WeSpeakEnglish/SEN6x_to_KEL_adapter/conn_tme.png

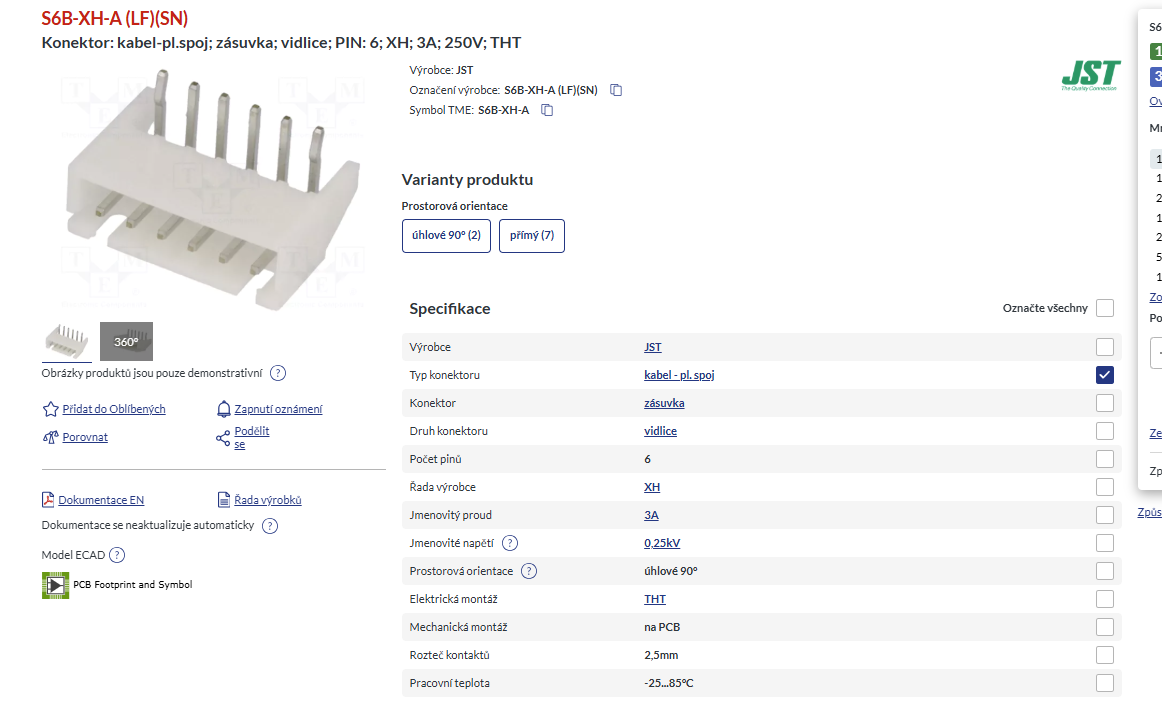
conn_tme.png
