WeSpeakEnglish/SEN6x_to_KEL_adapter/schematic.pdf

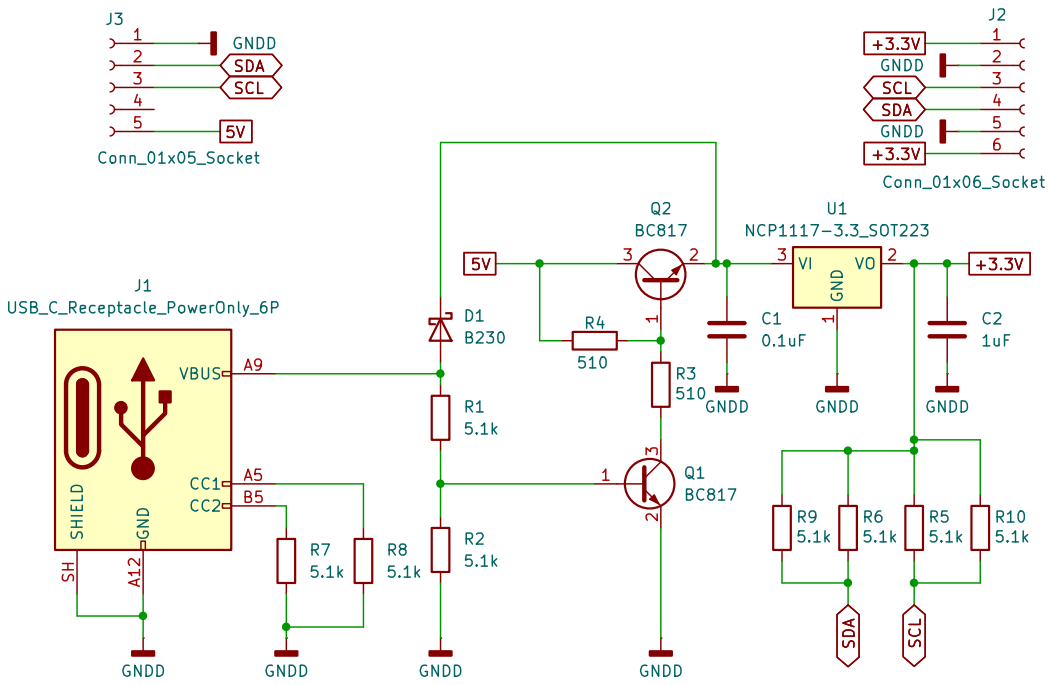
[picture p3: page 1]
