WeSpeakEnglish/SEN6x_to_KEL_adapter/adapter/adapter.kicad_pcb

## KiCad design adapter/adapter.kicad_pcb (2026-11-03)

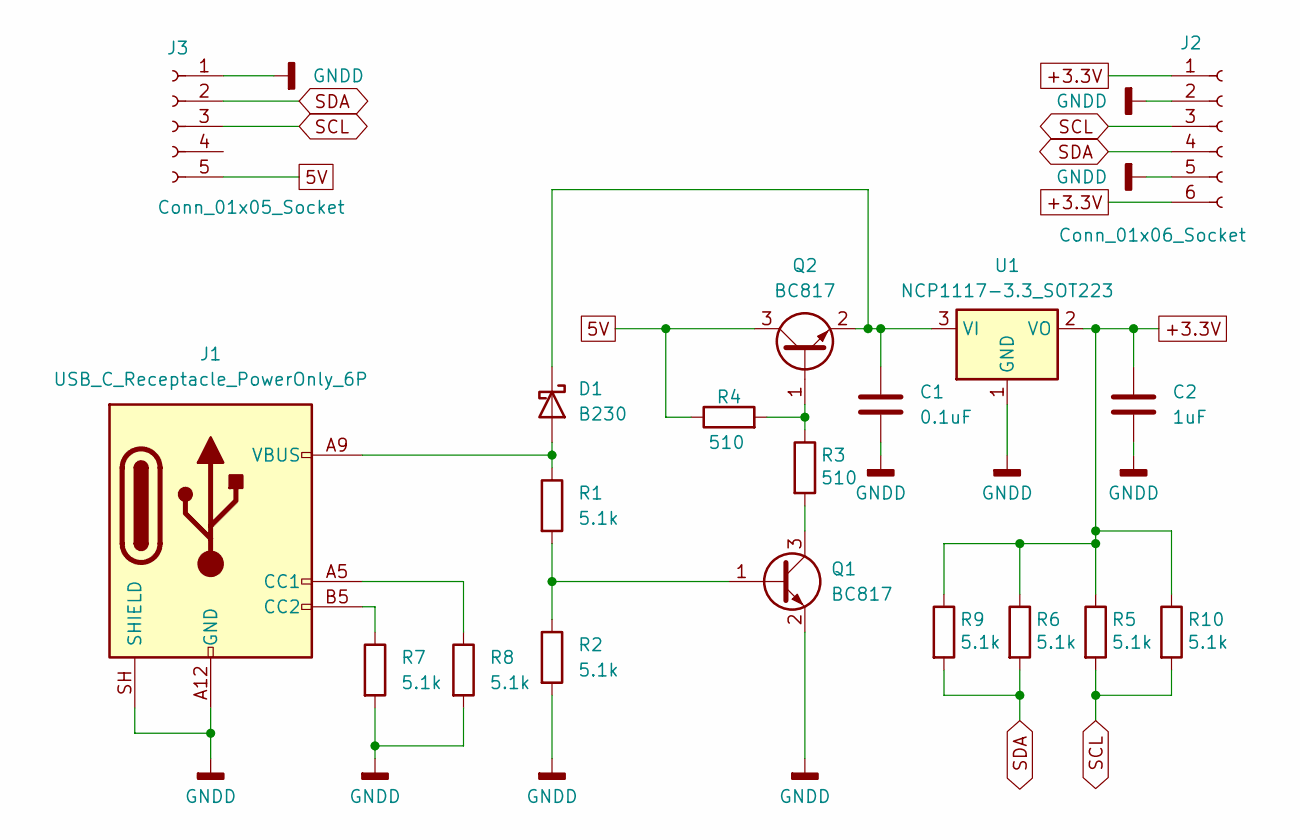
[picture p4: schematic adapter.kicad_sch]

Parts:
C1: 0.1uF; C_0805_2012Metric_Pad1.18x1.45mm_HandSolder
C2: 1uF; C_0805_2012Metric_Pad1.18x1.45mm_HandSolder
D1: B230; D_SMB
J1: USB_C_Receptacle_PowerOnly_6P; USB_C_Receptacle_GCT_USB4125-xx-x_6P_TopMnt_Horizontal
J2: Conn_01x06_Socket; JST_GH_SM06B-GHS-TB_1x06-1MP_P1.25mm_Horizontal
J3: Conn_01x05_Socket; PinHeader_1x05_P2.54mm_Horizontal
Q1, Q2: BC817; SOT-23
R1, R2, R5, R6, R7, R8, R9, R10: 5.1k; R_0805_2012Metric_Pad1.20x1.40mm_HandSolder
R3, R4: 510; R_0805_2012Metric_Pad1.20x1.40mm_HandSolder
U1: NCP1117-3.3_SOT223; SOT-223-3_TabPin2

Connections:
5V: J3.5, Q2.3 (C), R4.1
+3.3V: C2.1, J2.1, J2.6, R5.1, R6.1, R9.1, R10.1, U1.2 (VO)
GNDD: C1.2, C2.2, J1.A12 (GND), J1.B12 (GND), J1.SH (SHIELD), J2.2, J2.5, J3.1, Q1.2 (E), R2.2, R7.2, R8.2, U1.1 (GND)
unnamed: D1.2 (A), J1.A9 (VBUS), J1.B9 (VBUS), R1.1
unnamed: C1.1, D1.1 (K), Q2.2 (E), U1.3 (VI)
unnamed: J1.A5 (CC1), R8.1
unnamed: J1.B5 (CC2), R7.1
unnamed: Q1.1 (B), R1.2, R2.1
unnamed: Q1.3 (C), R3.2
unnamed: Q2.1 (B), R3.1, R4.2
SCL: J2.3, J3.3, R5.2, R10.2
SDA: J2.4, J3.2, R6.2, R9.2

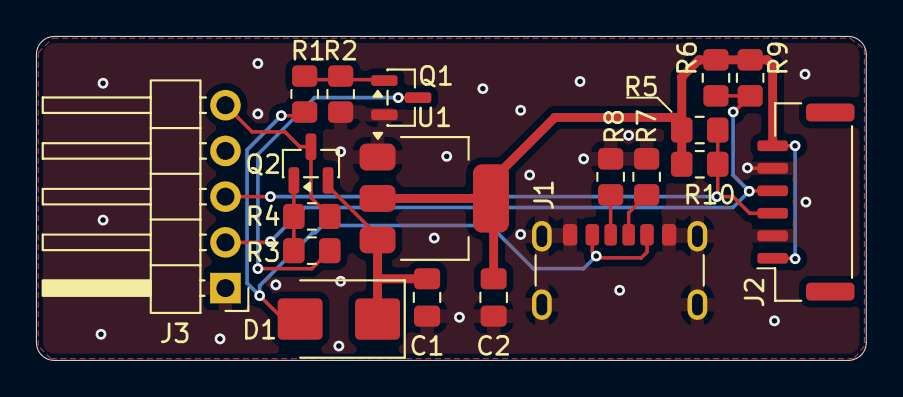
[picture p5: board adapter.kicad_pcb from above]

Board: 2 copper layers, 46.1 x 18.0 mm, 19 parts (0 on the bottom side), 12 nets.
