WeSpeakEnglish/SEN6x_to_KEL_adapter/(commit log)

2026-09-24 schematic added
    [adapter.kicad_pcb, adapter.kicad_sch]
2026-09-24 schematic apdated
    [adapter.kicad_sch]
2026-11-03 pcb png
